HybridAir/xmas_v3/README.md

# xmas_v3
The successor to 2015's xmas_v2
http://xmasv3.hybridair.me/
