HybridAir/xmas_v3/code/README.md

Final ATTiny24 compatible code

Use [this ATTiny core](https://github.com/damellis/attiny), set to the 8 MHZ internal clock. Make sure to burn the associated fuses.
