HybridAir/xmas_v3/(list of files, cad)

Other CAD files:
hardware/3d/xmas_v3.skp
