HybridAir/xmas_v3/hardware/pcb/xmas_v3.brd

## EAGLE design hardware/pcb/xmas_v3.brd (2016-11-12)

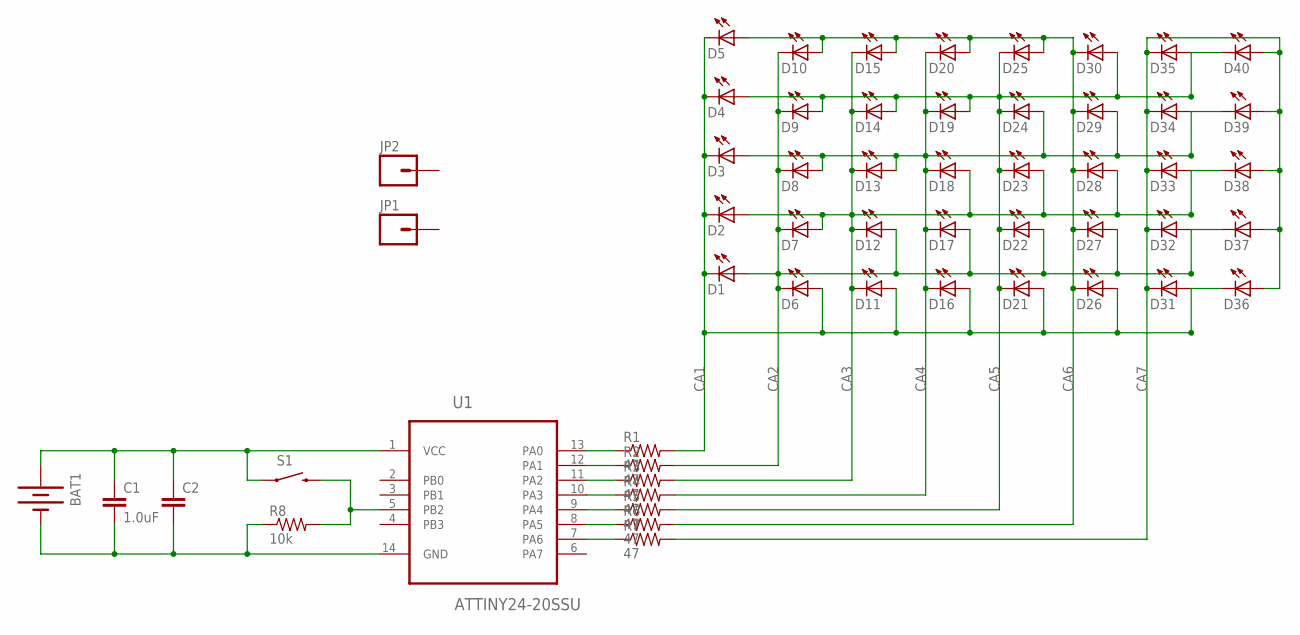
[picture p1: schematic xmas_v3.sch]

Parts:
BAT1: BATTERY20PTH; BATTCOM_20MM_PTH
C1: 1.0uF; 0805-CAP
C2: CAP0805; 0805
D1, D2, D3, D4, D5, D6, D7, D8, D9, D10, D11, D12, D13, D14, D15, D16, D17, D18, D19, D20, D21, D22, D23, D24, D25, D26, D27, D28, D29, D30, D31, D32, D33, D34, D35, D36, D37, D38, D39, D40: LEDCHIP-LED0603; CHIP-LED0603
JP1, JP2: M01PTH_NO_SILK_YES_STOP; 1X01_NO_SILK
R1, R2, R3, R4, R5, R6, R7: 47; R0603
R8: 10k; 0805
S1: SWITCH-MOMENTARY-2SMD-4; TACTILE_SWITCH_TALL
U1: ATTINY24-20SSU; SOIC127P600X175-14N

Connections:
CA1: D1.C, D2.C, D3.C, D4.C, D5.C, D6.A, D11.A, D16.A, D21.A, D26.A, D31.A, D36.C, R1.2
CA2: D1.A, D6.C, D7.C, D8.C, D9.C, D10.C, D12.A, D17.A, D22.A, D27.A, D32.A, D37.C, R2.2
CA3: D2.A, D7.A, D11.C, D12.C, D13.C, D14.C, D15.C, D18.A, D23.A, D28.A, D33.A, D38.C, R3.2
CA4: D3.A, D8.A, D13.A, D16.C, D17.C, D18.C, D19.C, D20.C, D24.A, D29.A, D34.A, D39.C, R4.2
CA5: D4.A, D9.A, D14.A, D19.A, D21.C, D22.C, D23.C, D24.C, D25.C, D30.A, D35.A, D40.C, R5.2
CA6: D5.A, D10.A, D15.A, D20.A, D25.A, D26.C, D27.C, D28.C, D29.C, D30.C, R6.2
CA7: D31.C, D32.C, D33.C, D34.C, D35.C, D36.A, D37.A, D38.A, D39.A, D40.A, R7.2
GND: BAT1.2 (-), C1.2, C2.2, R8.1, U1.14 (GND)
unnamed: BAT1.1 (+), C1.1, C2.1, S1.A2 (1), U1.1 (VCC)
unnamed: R8.2, S1.B2 (2), U1.5 (PB2)
unnamed: R1.1, U1.13 (PA0)
unnamed: R2.1, U1.12 (PA1)
unnamed: R3.1, U1.11 (PA2)
unnamed: R4.1, U1.10 (PA3)
unnamed: R5.1, U1.9 (PA4)
unnamed: R6.1, U1.8 (PA5)
unnamed: R7.1, U1.7 (PA6)

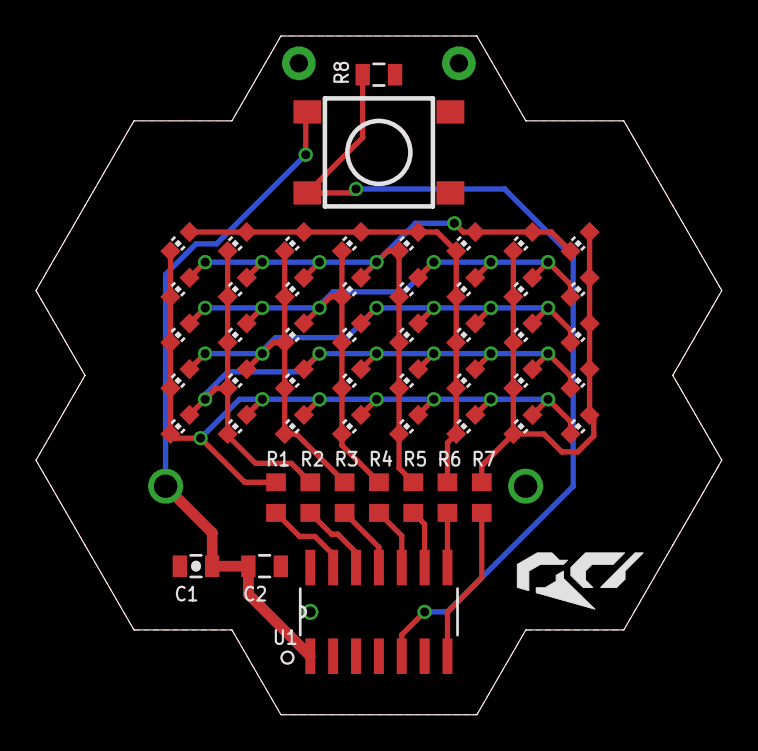
[picture p2: board xmas_v3.brd from above]

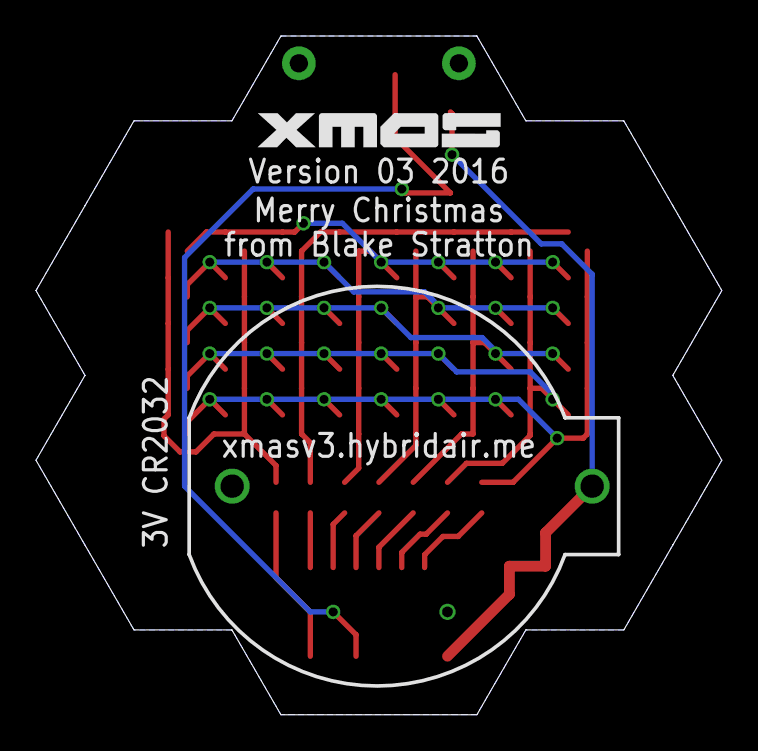
[picture p3: board xmas_v3.brd from below]

Board: 2 copper layers, 38.1 x 37.7 mm, 57 parts (2 on the bottom side), 17 nets.

Other parts of the board:
U$1: AR1
U$2: XMAS
