HybridAir/xmas_v3/code/mainProgram/mainProgram.ino

//main xmas_v3 program by HybridAir
//compiles to 2038 prog, 51 ram

#include <avr/sleep.h>
#include <avr/interrupt.h>
#include <util/delay.h>
#include <avr/pgmspace.h>
#include "mainProgram.h"


//the current frame to be displayed
byte frame[DISPLAY_HEIGHT] = {
    0b00000000,
    0b00000000,
    0b00000000,
    0b00000000,
    0b00000000
};


bool prevBtn = false;                           //last button state
byte savedStringIndex = 0;                      //array index of the currently selected message string
bool sleepEnabled = true;							//auto sleep enabled by default

extern volatile unsigned long timer0_millis;

void setup() {
    ADCSRA &= ~ bit(ADEN);                          //disable the ADC
	
	if((PINB & (1<<BUTTON))) {						//if the button is held during power up
		sleepEnabled = false;						//disable auto sleep
	}
     
    switchMessage();
}

unsigned long timer = 0;

void loop() {
    
    bool newBtn = (PINB & (1<<BUTTON));
    if(newBtn != prevBtn) {
        prevBtn = newBtn;
        
        if(newBtn) {                        //if the button was just pressed
            timer = millis();               //start the hold timer
        }
        else {                              //if the button was just released
            //check how long it was held for
            if(millis() >= timer + SLEEP_DELAY) {
                //switchMessage();
                sleep();
                //sleep here, above is for testing
            }
            else if(millis() >= timer + ANIM_DELAY) {
                savedStringIndex++;
                if(savedStringIndex >= TOTAL_STRINGS) {
                    savedStringIndex = 0;
                }
                switchMessage();
            }
        }
    }
    
     
    showMessage();
    renderFrame();
    clearFrame();
    
    if(sleepEnabled) {								//only check the sleep timer if auto sleeping is enabled
		if(millis() >= SLEEPTIME) {			//if the current time is greater than the sleeptime value
            sleep();									//go to sleep
        }
	}
}



//puts the device to sleep
void sleep() {
	DDRA = 0;      
    PORTA = 0;							//turn all LEDs off to save power

    GIMSK |= _BV(PCIE1);                     //enable Pin Change Interrupts
    PCMSK1 |= _BV(PCINT10);                   //use PB5 as interrupt pin to wake the device back up
    set_sleep_mode(SLEEP_MODE_PWR_DOWN);    //set the sleep mode
    sleep_enable();                         //sets the Sleep Enable bit in the MCUCR Register (SE BIT)
    sei();                                  //enable interrupts
    sleep_cpu();                            //sleep

	//wake up here
    
    //reset millis
    noInterrupts();
    timer0_millis = 0;
    interrupts();
    
    
    cli();                                  //disable interrupts
    PCMSK1 &= ~_BV(PCINT10);                  //turn off PB5 as interrupt pin so it can be used for other things
    sleep_disable();                        //clear SE bit
    sei();                                  //enable interrupts
	
	switchMessage();
}


//the program goes here directly after waking up
ISR(PCINT1_vect) {
}
