HybridAir/xmas_v3/code/mainProgram/mainProgram.h

#ifndef _MAINPROGRAM_h_
#define _MAINPROGRAM_h_

//MAIN
#define BUTTON              PB2
#define ANIM_DELAY			25						//min ms the button needs to be held to change animations
#define SLEEP_DELAY			1000					//min ms the button needs to be held to enable sleep mode
#define SLEEPTIME			3600000					//time in ms to wait until auto sleeping (1 hour, 4 minutes slow)
//#define SLEEPTIME			30000					//time in ms to wait until auto sleeping (1 hour, 4 minutes slow)

#define F_CPU 8000000UL


//DISPLAY
//display section names with their cooresponding charpliex pins
//F isn't used becuase AVR uses it for frequency stuff
/* #define A PA0
#define B PA1
#define C PA2
#define D PA3
#define E PA4
#define G PA5
#define H PA6 */
#define H PA0
#define G PA1
#define E PA2
#define D PA3
#define C PA4
#define B PA5
#define A PA6

//total number of leds in the display
#define NUM_LEDS 40

#define DISPLAY_WIDTH  8
#define DISPLAY_HEIGHT 5

#define NUM_SECTIONS 7
#define PREOFFSET 3


//ANIM
#define MAP_START      47

#define CHAR_WIDTH 5

#define TOTAL_STRINGS 5           
#define STRINGLENGTH 18          //largest string is 18 bytes long, so they all need to be

#define TEXTSPEED 100
#define FIRSTDELAY  1000

#endif
