HybridAir/xmas_v3/(commit log)

2016-10-23 my compiler doesn't like the word main by itself
    [mainProgram.ino]
2016-10-24 it compiles
    but doesn't work
    [anim.ino, mainProgram.h]
2016-11-02 Reverting back to the last working code
    [mainProgram.h, mainProgram.ino]
2016-11-04 Got basic led display working on the attiny
2016-11-04 Changed ledGrid to use progmem
    Got a fuckload of ram and storage back, works
2016-11-04 Made more optimizations to the display code
    Displays each whole section at once instead of a single led at a time,
    result is a brighter display but more program space, works
2016-11-06 Fixed character spacing
    works
    [anim.ino, mainProgram.ino]
2016-11-06 Barely got animation working
    it doesn't work right but it does something so, going to change a bunch
    of stuff now, but this is a decent reference point
    [anim.ino, mainProgram.h, mainProgram.ino]
2016-11-06 It's great when you don't remember what your own code did and you didn't comment it for some fuCKING REASON
    [anim.ino]
2016-11-06 I fixed the spacing problem, now I can get back on with my life
    [anim.ino, mainProgram.ino]
2016-11-07 Got button string switching working
    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
2016-11-07 Fixed some character maps
    [anim.ino]
2016-11-07 I added button detection code but millis() or something has decided to fuck with me
    why is this not working, like it compiles but
    [anim.ino, mainProgram.h, mainProgram.ino]
2016-11-08 Got button holding working
    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
2016-11-08 Added sleep timer
2016-11-08 Fixed the sleep timer
    works now, wouldn't immediately go to sleep after waking up
    [mainProgram.ino]
2016-11-08 Got it down to 2038 bytes compiled
    All done programming now (unless any new bugs appear), this should fit
    on an attiny24 now
    [anim.ino, mainProgram.h, mainProgram.ino]
2016-11-11 Changed display pinout to make pcb design easier
2016-11-11 All parts added
    [xmas_v3.brd]
2016-11-11 Ready for PCB design
    [xmas_v3.brd, xmas_v3_outline.dxf]
2016-11-12 Finished PCB design
    [xmas_v3.brd, xmas_v3.sch]
2016-11-12 Final minor changes
    [xmas_v3.brd, xmas_v3.sch]
2016-11-12 oops I forgot this
    [xmas_v3.brd]
